Sais01/Sistema_De_Analise_e_Monitoramento_De_Variaveis_Do_Ambiente/FN60C66IY4QHNH1.webp

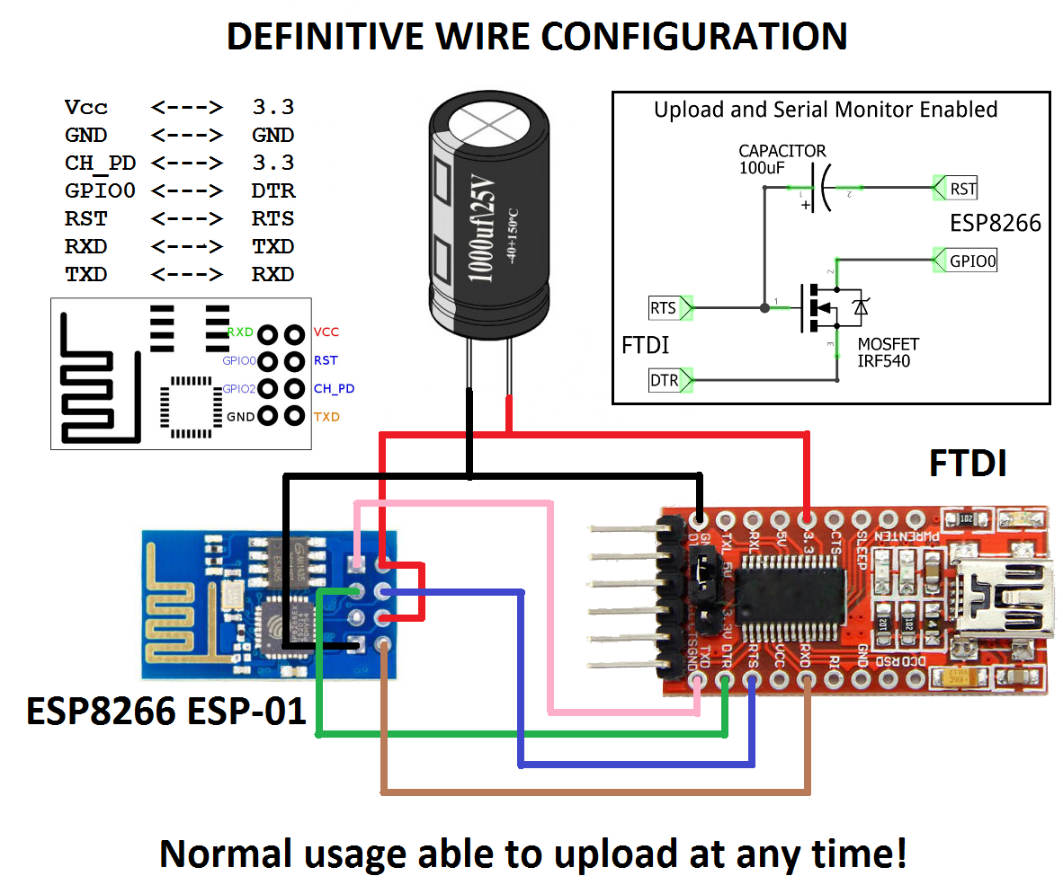
FN60C66IY4QHNH1.webp
