Sais01/Sistema_De_Analise_e_Monitoramento_De_Variaveis_Do_Ambiente/imagens/involucroFechado.jpeg

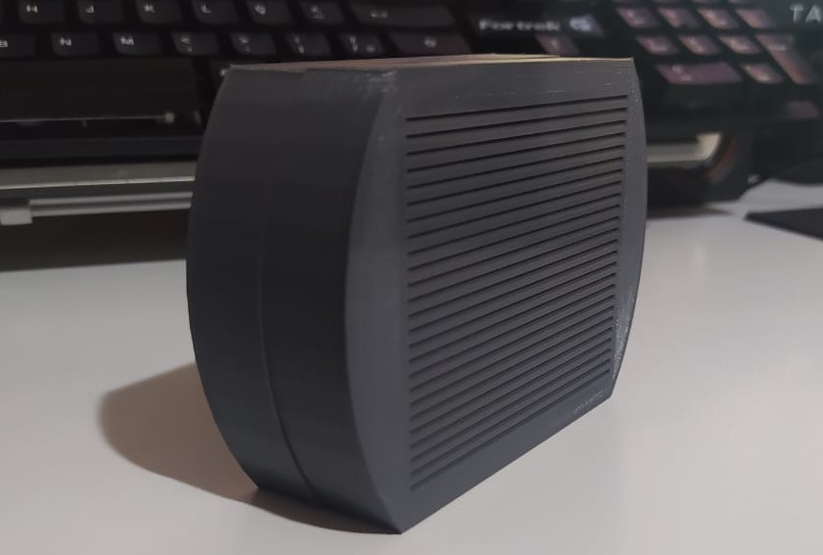
imagens/involucroFechado.jpeg
