Sais01/Sistema_De_Analise_e_Monitoramento_De_Variaveis_Do_Ambiente/deuCerto/mainDHT11.py

from umqttsimple import MQTTClient
import ubinascii
import machine
import time
from bmp280 import BME280
import network
import dht

def escreverTexto(conteudo):
  
    texto_escrito = open("i2c.txt", 'a')
    texto_escrito.write (conteudo + "\n")
    texto_escrito.close()

def escreverDados(conteudo):
  
    texto_escrito = open("BMP.txt", 'a')
    texto_escrito.write (conteudo + "\n")
    texto_escrito.close()

i2c = machine.I2C(scl=machine.Pin(2), sda=machine.Pin(0))

dht11 = dht.DHT11(machine.Pin(1,machine.Pin.IN))#TX

#%%%%% Informações wifi e MQTT %%%%%%%
ssid = 'SAIS'
password = 'cristofer'
mqtt_server = 'broker.mqttdashboard.com'

client_id = ubinascii.hexlify(machine.unique_id())
#%%%%%%%%%%%%%%%%%%%%%%%%%%%%%%%%%%%%%

#%%%%%%%%%% Tópicos MQTT %%%%%%%%%%%%%
topico_temperatura_dht = b'cristofer/temperatura_dht'
topico_temperatura_bmp = b'cristofer/temperatura_bmp'
topico_umidade = b'cristofer/umidade'
topico_pressao = b'cristofer/pressao'
topico_i2c = b'cristofer/i2c'
#%%%%%%%%%%%%%%%%%%%%%%%%%%%%%%%%%%%%%

#%%%%% Configuracao e inicializacao MQTT %%%% 
last_message = 0
message_interval = 2

station = network.WLAN(network.STA_IF)

station.active(True)
station.connect(ssid, password)

while station.isconnected() == False:
  pass

def connect_mqtt():
  global client_id, mqtt_server
  client = MQTTClient(client_id, mqtt_server)
  client.connect()
  return client

def restart_and_reconnect():
  time.sleep(10)
  machine.reset()

try:
  client = connect_mqtt()
except OSError as e:
  restart_and_reconnect()
#%%%%%%%%%%%%%%%%%%%%%%%%%%%%%%%%%%%%%%
while True:
    try:
        if (time.time() - last_message) > message_interval:
            devices = i2c.scan()

            if len(devices) == 0:
                escreverTexto("No i2c device !")
                client.publish(topico_i2c, "No i2c device !")
            else:
                escreverTexto("i2c devices found:{}".format(len(devices)))
                client.publish(topico_i2c, "i2c devices found:{}".format(len(devices)))
                bmp = BME280(i2c=i2c)
                
                escreverDados("Temperatura:{}".format(bmp.values[0]))
                client.publish(topico_temperatura_bmp, "Temperatura:{}".format(bmp.values[0]))
                
                escreverDados("Pressao:{}".format(bmp.values[1]))
                client.publish(topico_pressao, "Pressao:{}".format(bmp.values[1]))

                for device in devices:  
                    escreverTexto("Hexa address: {}".format(hex(device)))  
                    client.publish(topico_i2c, "Hexa address: {}".format(hex(device)))
            
            dht11.measure()
            client.publish(topico_umidade, str(dht11.humidity()))
            client.publish(topico_temperatura_dht, str(dht11.temperature()))
            last_message = time.time()
    except OSError as e:
        restart_and_reconnect()
