Sais01/Sistema_De_Analise_e_Monitoramento_De_Variaveis_Do_Ambiente/(commit log)

2022-08-04 finalizando primeira etapa Fritzing
    [Esquematico.fzz]
2022-08-11 finalizando aula 11/08/22
    [Esquematico.fzz]
2022-08-18 finalizando processo inicial com tudo funcionando 18/08
    [Esquematico.fzz]
2022-08-18 finalizando Protoboard e esquematico
    [Esquematico.fzz]
2022-08-18 finalizando PCB
    [Esquematico.fzz]
2022-08-18 finalizando fritzing 18/08
    [Esquematico.fzz]
2022-10-05 fazendo commit antes de sleep
    [Esquematico.fzz]
2022-11-26 adicionano imagens texto TCC
    [Esquematico.fzz]
